SpiderBlocker/TSA5511_PLL_Controller_Arduino/(commit log)

2024-10-14 Add files via upload
    Added LCD backlight control, including automatic dimming. Brightness level for PLL lock LED can also be set.
2024-10-27 Add files via upload
    Reset dimmer timer after frequency change.
2025-02-04 Add files via upload
    Basic circuit diagram for use with an Arduino Nano and 1602A LCD display module
2025-02-08 Add files via upload
    reset on SET button release in case of I2C error
2025-02-22 Add files via upload
    Allow UP/DOWN to interrupt dimmer message display for frequency setting
2025-03-23 Add files via upload
    Added periodic I2C check and blinking LED during I2C error
2025-03-23 Add files via upload
    Added periodic I2C check and blink lock led if there is an error
2025-03-28 Add files via upload
    Removed delay in I2C errorhandler, as it doesn't impact CPU power consumption
2025-04-13 Add files via upload
    Refactored code for use of millis()
2025-05-29 Add files via upload
    - Optimized behaviour on fast sequential button presses (no more delay between 1st and 2nd press);
    - Optimized behaviour when multiple buttons are pressed (no more erratic effects);
    - Refactored setup() and loop() functions;
    - Restructured globals section;
    - Various small optimizations and additional comments;
    - Version incremented to V1.7.
2025-06-07 Add files via upload
    Menu options lower case
2025-06-07 Add files via upload
    Fixed an issue where the system became unresponsive to button presses if multiple buttons were pressed simultaneously in frequency set mode.
2025-06-16 Add files via upload
    - Fixed I2C address mismatch, which was due to incorrect reference from TSA5511 datasheet; it now works as intended;
    - Added menu option for TSA5511 unique I2C-address selection and a menu option for output ports setting during locked state;
    - Added fail-safe I2C address fallback (0x61) when holding SET during startup;
    - Various improvements and code refactoring.
2025-06-30 Add files via upload
    Watchdog timer: added .init3 disable for legacy support
2025-07-22 Update README.md
    Added circuit diagram
2025-07-22 Add files via upload
    Circuit diagram
2025-08-07 Add files via upload
    Changed I2C-reset notification label on display.
2025-10-26 Add files via upload
    - Added option to disable charge pump (for testing purposes);
    - Drive charge pump and output ports according to settings, only after PLL lock state has been acquired;
    - Various code refinements.
2025-10-27 Reformat CHARGE PUMP section in README.md
2025-10-27 Add files via upload
    - Made menu option CHARGE PUMP non-cyclic
    - Minor code refactoring
2025-10-28 Add files via upload
    Reversed sequence of menu options under PLL SETTINGS => CHARGE PUMP (now high <-> low <-> disabled)
2026-03-23 Add files via upload
    Refined XTAL frequency display logic and simplified button repeat timing (same functional behavior)
2026-04-24 Add files via upload
    • Refined VCO frequency handling by replacing remaining float/long usage with integer-based unsigned long logic.
    • Changed predefined VCO frequency bands to unsigned long constants to avoid floating-point rounding effects.
    • Reworked frequency step multiplier calculation to use integer arithmetic instead of pow()/ceil().
    • Updated frequency validation to use integer rounding when aligning to valid PLL steps.
    • Improved datatype consistency for current, target and stored VCO frequencies.
    • Clarified various comments and header text.
2026-05-12 Add files via upload
    • Added landing page callout card
    • Minor restyling
2026-05-20 Add files via upload
    • Centralized default values and EEPROM validation constants to improve robustness, readability, and maintainability.
    • Added a double-confirmed Clear Settings menu option to erase stored EEPROM settings and reload safe defaults.
2026-05-21 Add files via upload
    • Added protection against duplicate PLL output-port assignments while preserving 'none' as a valid shared option.
    • Improved EEPROM sanitizing for legacy or corrupted duplicate output-port mappings.
    • Added direction-aware VCO band-edge alignment to keep lower and upper limits safely inside the selectable frequency range.
    • Introduced LCD column/row constants for cleaner display-dimension handling.
    • Made frequency constants explicitly unsigned long for safer arithmetic.
    • Cleaned up charge-pump disabled handling by avoiding the CP bit when varicap drive is disabled.
2026-06-01 Add files via upload
    • Added a dedicated QUICK MENU, opened by holding SET from the main interface;
    • Added user memory support with six memory slots per VCO frequency band and XTAL frequency;
    • Added quick-menu actions to recall, save, and clear user memory slots;
    • Added a temporary RF DRIVE on/off override from the quick menu, without storing the override state in EEPROM;
    • Added automatic RF DRIVE: OFF status alternation on the main display while RF drive is temporarily disabled;
    • Moved LCD-off control from direct SET long-press handling to the QUICK MENU;
    • Added animated entry titles for SYSTEM SETTINGS and QUICK MENU;
    • Refined menu navigation with SET long-pre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
2026-06-02 Add files via upload
    • Added a persistent SHOW MENU TITLE option to GENERAL SETTINGS to enable or disable the animated SYSTEM SETTINGS / QUICK MENU entry title.
    • Added EEPROM-backed storage and default handling for the menu title display preference.
    • Renamed CLEAR SETTINGS to FACTORY RESET throughout the UI and code for clearer double-confirmed reset semantics.
    • Refined header usage documentation for SYSTEM SETTINGS, QUICK MENU, SET long-press return behavior and menu timeout behavior.
    • Slightly shortened the menu entry title animation step delay for a smoother, less lingering transition.
2026-06-09 Add files via upload
    • Shortened SET long-press and menu-title delays for quicker access to the QUICK MENU and faster menu escape handling.
    • Consolidated UI timing constants.
    • Clarified I²C address verification, factory reset behaviour, PLL lock polling and output-port mapping notes.
    • Aligned inline comments, README and landing page wording.
2026-06-10 Add files via upload
    • Made SET button behaviour consistent across the user interface.
    • Frequency changes are now confirmed with a short SET press after release, instead of immediately on button press.
    • Holding SET in frequency edit mode now cancels the pending frequency change and returns to the main screen unchanged.
    • Updated the station-name editor so short SET confirms the current character, while holding SET returns from the editor.
    • Improved multi-button handling by suppressing unintended button events until all buttons have been released.
2026-07-17 Add files via upload
    Fixed a potential false SET double-click detection after millis() rollover.
2026-07-18 Add files via upload
    Added TSA5511 power-on-reset (POR) monitoring with automatic PLL reprogramming after an unexpected IC reset
2026-07-18 Add files via upload
    • Added TSA5511 power-on-reset monitoring with automatic PLL reprogramming after an unexpected IC reset.
    • Added a short PWM fade-out when switching the LCD backlight off from the Quick Menu.
2026-07-19 Add files via upload
    • Added set-and-forget I²C communication recovery with timed retries and persistent fault indication.
    • Added TSA5511 POR monitoring to detect and recover from unexpected PLL resets.
    • Fully reprogrammed the PLL automatically after communication recovery or POR detection.
    • Continued periodic TSA5511 status monitoring during menu operation and frequency editing.
    • Discarded unsaved menu changes and cancelled unconfirmed frequency edits when recovery is required.
    • Replaced the watchdog-based manual restart flow with unattended recovery for true set-and-forget operation.
    • Clarified PLL control terminology and correctly identified the disabled mode as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
2026-07-20 Add files via upload
    • Added state-aware I²C recovery distinguishing read interruptions from uncertain writes.
    • Preserved existing PLL programming after read-only interruptions without POR.
    • Resumed acquisition and lock verification when required, without rewriting the divisor.
    • Limited full PLL reprogramming to failed/uncertain writes and TSA5511 POR events.
    • Unified locked/unlocked output-port updates and hardened EEPROM station-name validation.
2026-07-24 Add files via upload
    Prevent PLL lock when the charge pump is disabled.
2026-07-25 Add files via upload
    Fixed LCD OFF incorrectly disabling the lock LED.
2026-07-25 Add files via upload
    • Added SDA/SCL I²C bus visuals.
    • Aligned the left footer divider to match up with the right panel.
2026-07-25 Add files via upload
    • Minor visual corrections.
    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
2026-07-27 Add files via upload
    • Fixed faint cursor visibility during blink-off phase.
    • Reordered SET and keyboard hints for clearer UI hierarchy.
2026-08-09 Add files via upload
    • Added SERVICE MENU with diagnostics, system info and factory reset (press UP/DOWN simultaneously for ≥ 1 s from the main interface).
    • Added live TSA5511 status, lock timing, POR and I²C recovery diagnostics.
    • Improved I²C recovery handling and diagnostics persistence during communication faults.
    • Added adaptive SYSTEM MENU exit handling based on actual setting changes.
    • Updated firmware/version presentation and menu documentation.
    • Standardized menu exit labels to EXIT MENU.
2026-08-13 Add files via upload
    • Added startup Service Menu access with read-only pre-initialization diagnostics and startup-only I²C fallback.
    • Improved diagnostics with POR baseline handling, unknown/stale-data indication, lock-time and output-port initialization status, and refined recovery counters.
    • Improved PLL lock monitoring and state-aware I²C recovery, avoiding unnecessary reprogramming after read-only interruptions without POR.
    • Refined UP/DOWN Service Menu chord handling and frequency-edit interaction to prevent residual gestures after timeout.
    • Added clearer VCO band labels and several diagnostics/UI consistency refinements.
    • Updated interactive demo and documentat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
2026-08-14 Add files via upload
    • Added symbolic frequency-band identifiers and replaced remaining numeric band indices.
    • Consolidated diagnostics counter saturation into a shared constant and grouped diagnostics-specific settings.
    • Refined startup diagnostics output-port labeling (PORT COMMAND).
    • Reordered selected constants and runtime variables for improved consistency and readability.
    • Updated related comments and removed remaining diagnostics magic values without changing functional behavior.
2026-08-16 Add files via upload
    • Improved frequency-step alignment so every selectable PLL frequency is exactly representable at the chosen display precision.
    • User memories now retain and display their exact stored frequency independently of the current precision setting.
    • Memory recall automatically raises precision only when required for exact reproduction, without lowering an existing higher precision.
    • Improved validation/restoration of stored band frequencies and user memories against PLL step, band and divisor limits.
    • Refactored startup Service Menu/status initialization for cleaner code structure without changing behaviour.
    • Minor documentation/comment cleanup and firmwa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
2026-08-17 Add files via upload
    • Added SERVICE MENU access and navigation during runtime I²C recovery.
    • Kept SERVICE MENU / DIAGNOSTICS context intact across repeated I²C failures and recovery.
    • Improved DIAGNOSTICS recovery display: unavailable FL/input data now shows - and interrupted PLL lock timing shows <unknown>.
    • Invalidated lock-time measurements across read interruptions and only resumes valid timing from a new uninterrupted acquisition.
    • Removed modal I²C error feedback from DIAGNOSTICS, keeping diagnostics browsable during recovery.
    • Centralized the diagnostics I²C status marker in display().
    • Converted the menu-entry transition to a non-blocking millis()-based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
2026-08-21 Add files via upload
    • Improved startup DIAGNOSTICS I²C fault handling: affected pages are marked with "!" immediately, while sustained failures replace stale FL/input values with "-".
    • Improved DIAGNOSTICS display layout by shortening the P6-ADC label to P6, keeping the I²C fault marker visually separate.
    • Simplified frequency-change, I²C-address verification and menu-display code by removing redundant temporary variables and indirection.
    • Consolidated the startup diagnostics retry state without changing normal runtime I²C recovery behaviour.
2026-08-25 Add files via upload
    Added a compile-time EEPROM boundary check for the user-memory bank.
    • Removed redundant menu-state assignments and frequency validations.
    • Simplified station-name storage while retaining EEPROM update semantics.
    • Reduced unnecessary LCD writes without lowering the PLL FL-bit polling rate.
    • Improved diagnostics handling before the PLL has been initialized.
    • Preserved the original menu-lock timing after an automatic menu timeout.
2026-08-27 Add files via upload
    • Made System Menu settings fully transactional; pending changes no longer affect the active configuration until saved.
    • Added a dedicated FACTORY RESET / resetting... status with a 750 ms minimum display time.
    • Replaced remaining service-chord magic states with named constants.
2026-08-28 Add files via upload
    • Refined main-screen input handling and naming following the addition of the UP/DOWN Service Menu chord.
    • Fixed an XTAL-selection edge case where pressing beyond the selection boundary could unintentionally reset frequency precision.
    • Minor code-clarity and maintenance improvements, including EEPROM-layout documentation.
2026-08-31 Add files via upload
    • Added SYSTEM UPTIME diagnostics with rollover-safe timing and differential LCD updates.
    • Added PLL DIVISOR diagnostics and separate I2C ADDRESS / I2C RECOVERIES pages.
    • Added single NO/YES confirmation for startup I2C FALLBACK; FACTORY RESET retains double confirmation.
    • Hardened menu-entry input handling with a release guard and non-blocking transition handling.
    • Reduced unnecessary LCD redraws in diagnostics, station-name editing and RF-drive status display.
    • Improved settings/menu UI consistency, including explicit edit prompts and PORT MAPPING phase indication.
    • Replaced raw timing sentinels/thresholds with named constants and tightened co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
2026-08-31 Add files via upload
    Keep SYSTEM UPTIME updating during I²C recovery and added startup DIAGNOSTICS fault-LED indication.
2026-09-03 Add files via upload
    • Improved button-release guarding across menu transitions, frequency confirmation and LCD wake-up.
    • Replaced blocking LCD wake-up handling with release-safe input suppression for all buttons.
    • Extended read-only I²C monitoring and fault indication across the entire startup Service Menu.
    • Kept all Service Menu and Diagnostics pages accessible and visibly marked during runtime I²C recovery.
    • Refined diagnostic labels, hardware/input documentation and several small code-efficiency details.
    • Added a safe minimum repeat interval for exceptionally long frequency-adjustment holds.
2026-09-04 Add files via upload
    • Fixed startup SERVICE MENU entry animation being interrupted by I²C fault-marker updates.
    • Improved FACTORY RESET handling during active or newly triggered I²C recovery to keep LCD and recovery state consistent.
    • Kept the fault LED blinking during startup I²C fallback while the existing ! fault indication remains active.
2026-09-13 Add files via upload
    • Refined DIAGNOSTICS input-port reporting by masking actively driven TSA5511 ports while preserving raw startup status.
    • Centralized diagnostic saturation and PLL lock-time overflow text with compile-time consistency guards.
    • Added LCD self-healing after completed I²C recovery, with startup and recovery initialization centralized through display(LCD_INITIALIZE).
    • Tightened time-unit typing and improved comments, naming and code-style consistency without changing operational PLL behavior.
2026-09-16 Add files via upload
    • Standardized index/count types and local naming for improved code consistency and readability.
    • Reduced redundant LCD redraws and repeated backlight PWM writes when values remain unchanged.
    • Cached the VCO step within frequency calculations to avoid unnecessary repeated evaluation.
    • Added a compile-time guard for menu-level ordering assumptions.
    • Minor code-organization cleanup; no functional changes.
2026-09-19 Add files via upload
    • Removed the startup SET-held Service Menu path; Service Menu access is now consistently handled through the UP+DOWN runtime gesture, including during I²C recovery.
    • Moved I2C FALLBACK to active recovery only, restoring the fail-safe 0x61 address without the previous separate startup service mode.
    • Made the startup splash non-blocking so PLL initialization and monitoring can proceed concurrently, with a short TSA5511 power-up settling interval and guarded startup input.
    • Refined PLL lock-time measurement to end on the successful TSA5511 status read that reports FL set.
    • Simplified startup/recovery state handling and removed obsolete startup-specific I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
2026-09-19 Add files via upload
    • Fixed I²C fallback/error LED continuity, including Factory Reset during active recovery.
    • Restored the lock LED state after a failed newly selected I²C address falls back to the previous address.
    • Avoided unnecessary TSA5511 reprogramming on SAVE CHANGES; reprogramming now occurs only when PLL-related settings or the effective VCO frequency change.
    • Suppressed UP/DOWN/SET buttons still held when I²C recovery completes, preventing unintended frequency changes.
    • Restored the compile-time output-port indexing sanity check.
    [PLL_TSA5511_1602A_v5_3_1.ino]
2026-10-09 Add files via upload
    • Added non-blocking quadratic LCD backlight dimming and fade-out.
    • Improved LCD OFF wake-up handling with button-release protection.
    • Converted both I²C fallback notifications to non-blocking operation.
    • Improved SET-button confirmation priority and menu navigation consistency.
    • Refined station-name editor input handling and auto-repeat behavior.
    • Minor code cleanup and improved PLL/I²C documentation.
